Samu4035/REDMACHINE-2025/v-photos/pompo right.jpg

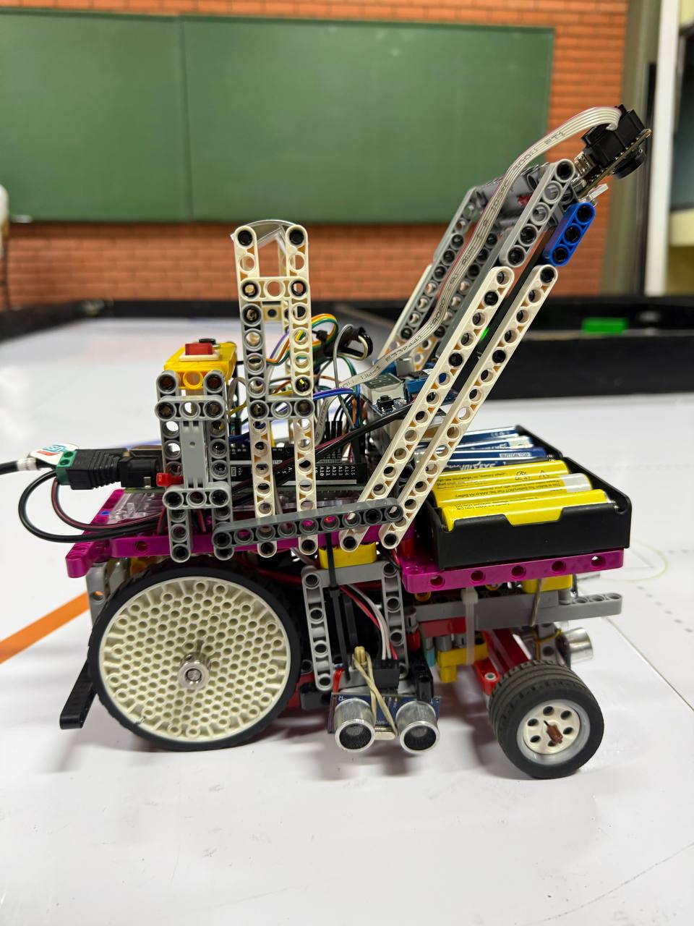
v-photos/pompo right.jpg
