Samu4035/REDMACHINE-2025/v-photos/pompo bottom.jpg

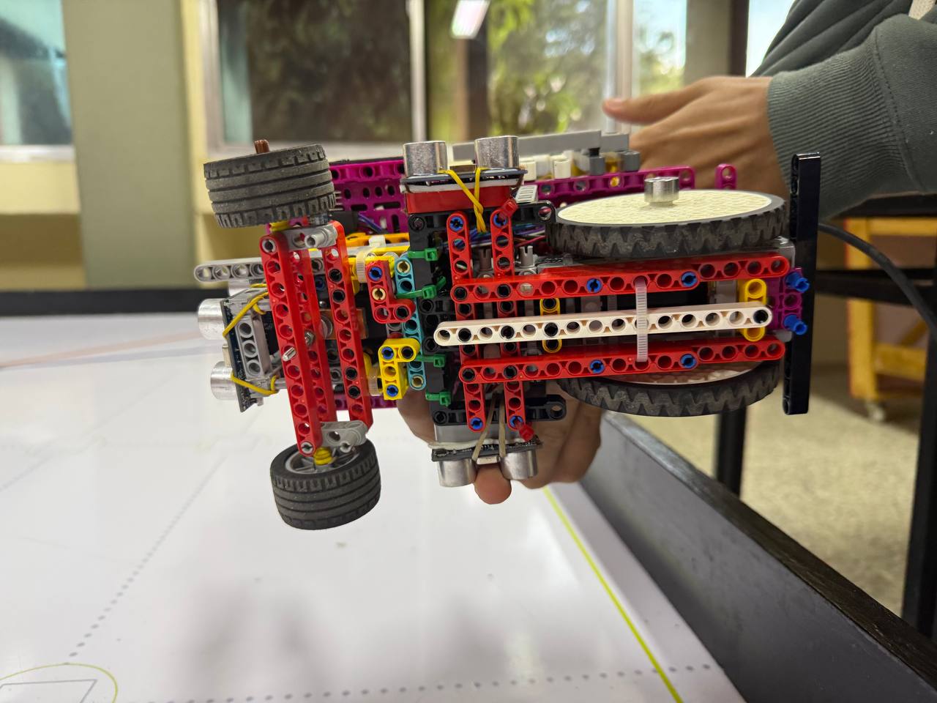
v-photos/pompo bottom.jpg
