Samu4035/REDMACHINE-2025/schemes/Hardware.md

# Index
- [Motors](https://github.com/Samu4035/REDMACHINE-2025/blob/main/schemes/Hardware.md#Analysis-of-Motor-Function)
- [Sensors](https://github.com/Samu4035/REDMACHINE-2025/blob/main/schemes/Hardware.md#Sensors)
- [Camera](https://github.com/Samu4035/REDMACHINE-2025/blob/main/schemes/Hardware.md#Camera)
- [Controller Boards](https://github.com/Samu4035/REDMACHINE-2025/blob/main/schemes/Hardware.md#Controller-Boards)
- [Robot Power Supply](https://github.com/Samu4035/REDMACHINE-2025/blob/main/schemes/Hardware.md#Robot-Power-Supply)
- [Connection Diagrams](https://github.com/Samu4035/REDMACHINE-2025/blob/main/schemes/Hardware.md#Connection-Diagrams-🔌)

# Analysis of Motor Function
The following section will display aspects of the function of the 2 motors of our robot.

## Core Hex Motor 🤖
Pompo will be moved with a core hex motor on the singapore international final



This motor is powered by a 2-pin JST-VH connector 

 

- Installation: To use this motor in the way the team requires, a 5 mm hexagonal shaft is used, with one end protruding from each side of the motor. The shaft has a length of 11.8 cm and is made of stainless steel. On each end of this shaft, a traction wheel with a diameter of 90 mm was mounted. Finally, these wheels were secured to the shaft using collars equipped with a set screw that tightens against the shaft.
     This structure is hold by lego pieces, from the same kit as the rest of the robot parts.


  
- Weight: 7 ounces
- Torque: 3.2 N·m
- Operating Voltage: 12 V
- No-load Speed: 125 RPM

## Rev Robotics Servomotor



- Installation: As with "Luka," the previous robot, to connect this servo to the front-wheel drive, a cut double aluminum servo arm was anchored to the Smart Robot Servo. Then, a screw was placed in one of the inputs of the aluminum arm, which connected it to two Lego pieces. A second screw joins the two aforementioned Lego pieces. Likewise, two chassis screws were anchored to the third Lego piece, so that it would function as a support. Finally, the wheels were placed, which fit between the three Lego pieces.

System Example:
 
 

foto sistema direccion 2

foto sistema direccion 1

The servo is held joined to the chassis in a fixed position with a set of Lego pieces.

- Operating Voltage: From 4.8V to 7.4V. In the robot, the servo operates at 5V.
  
- Rotation Range: It can rotate up to 270 degrees.

- Torque: 13.5 kg-cm

- Speed: 0.13s/60º

- Weight: 2.05 ounces

- Gear Material: Brass

- Power: The servo's power is specified below.

- Input Pulse:
   Minimum-500 μs
   Center-1500 μs
   Maximum-2500 μs



# Sensors
The specifications for the sensors found in "Pompo" will be displayed below.

## Ultrasonic Sensors
Three ultrasonic sensors are used to define the distance between the robot and the track walls, specifically the lateral and frontal walls depending on the direction the robot is moving.



- Connection Pins:
   VCC
   Trig (ultrasound trigger)
   Echo (ultrasound reception)
   GND



- Power Supply Voltage: 5 V

- Operating Frequency: 40 KHz

- Maximum Detection Range: 450cm

- Minimum Detection Range: 2cm

- Detection Angle: 15 degrees

- Current Consumption: 15mA

## Gyroscope
An MPU6050 is used to measure the degrees of each turn and to know when the robot should stop turning. The gyroscope is used both to avoid traffic signals and to execute turns, as well as to help the robot stay straight through a PID process.



- Connection Pins:
Vin           
3V      
P50       
GND         
PS1          
SDA         
INT          
SCL  
ADR      
RST 

The team uses the Vin input to power the sensor, the GND pin, and the SDA and SCL pins to establish communication between the Arduino and the MPU6050.

Data Output (BNO055)
The BNO055 can output the following sensor data:

- Absolute Orientation (Euler Vector, 100 Hz): Three-axis orientation data based on a 360-degree sphere.

- Absolute Orientation (Quaternion, 100 Hz): Four-point quaternion output for more precise data manipulation.

- Angular Velocity Vector (100 Hz): Three axes of "rotation speed" in rad/s.

- Acceleration Vector (100 Hz): Three axes of acceleration (gravity + linear motion) in m/s^2.
  
- Magnetic Field Strength Vector (20 Hz): Three axes of magnetic field detection in micro Tesla (uT).

- Linear Acceleration Vector (100 Hz): Three axes of linear acceleration data (acceleration minus gravity) in m/s^2.

- Gravity Vector (100 Hz): Three axes of gravitational acceleration (minus any movement) in m/s^2.

# Camera
Pompo uses a camera to detect the color of traffic signals. This is the Pixy2.

pixy2.1

The Pixy2 works at 60 fps, and is capable of detecting objects, lines, and colors. In Pompo, the main objective of the camera is to detect colors (red and green). It connects to the Arduino with an IDC 2 ICSP Arduino cable that goes into the ICSP pins of the Arduino, which provides all the necessary connections for power and communication with the Pixy.

# Controller Boards
Pompo uses a single controller board: an Arduino Mega 2560. The Arduino is in charge of controlling the actuators, sensors, and all movement of the robot.

## Arduino Mega 2560



- Power Supply: 9V

- Pins Used: 21

- Maximum Current per Pin: 40 mA

- Flash Memory: 256 KB

- SRAM: 8 KB

- Weight: 37 grams

- Consumption: 93 mA

# Robot Power Supply 
Pompo uses 6 3.7v batteries, separated in two circuits. 

## Motor Power Circuit 
This circuit uses three batteries. The three batteries are connected in series, so the voltage is summed. The H-bridge is the electrical component that receives this energy and uses it to power the the traction motor.
To connect the batteries, the team uses a battery pack of three batteries. 



## Arduino and sensors Circuit 
This circuit uses the other 3 batteries, connected as well in series. The three batteries separate into two voltage regulators, one for the sensors and one for the arduino.
The one that powers the sensors (gyroscope and ultrasounds) is regulated on 5v, and the one for the arduino is regulated on 8,4v. The arduino powers the servomotor and the pixycam. 



# Connection Diagrams 🔌
To better understand Pompo's electrical circuits, the connection diagrams for our robot are presented below:

## Sensors diagram



## Motors diagram
