Samu4035/REDMACHINE-2025/otros/diagrama de coneccion motores.png

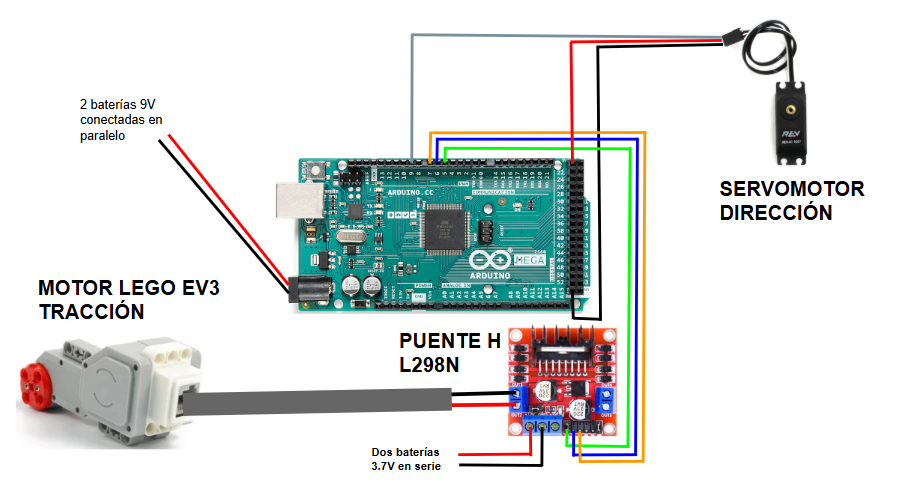
otros/diagrama de coneccion motores.png
