Samu4035/REDMACHINE-2025/otros/diagrama de coneccion sensores.png

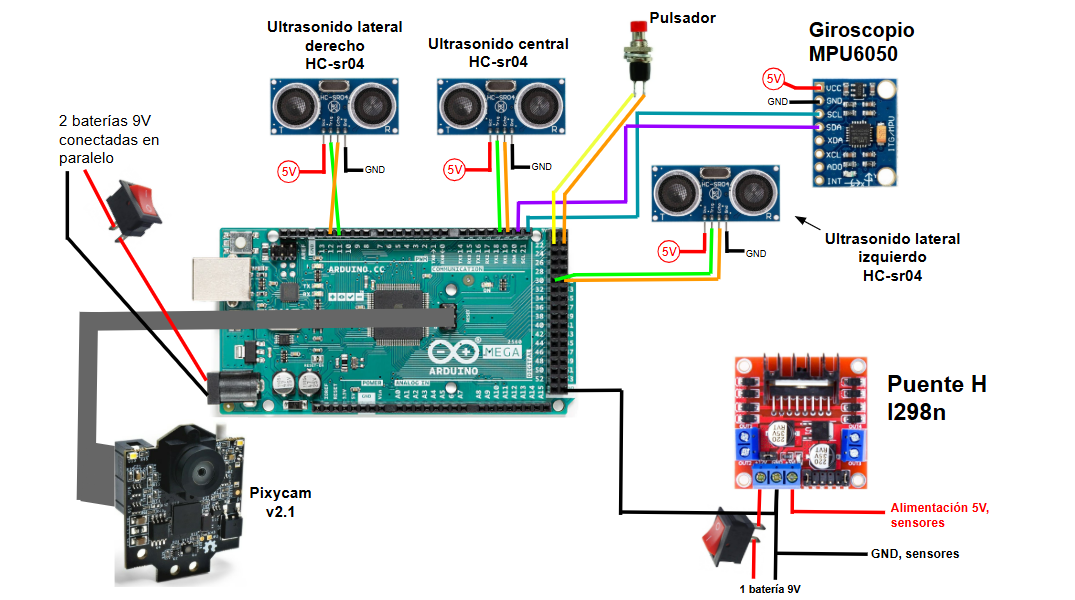
otros/diagrama de coneccion sensores.png
