Samu4035/REDMACHINE-2025/schemes/motors diagram final.png

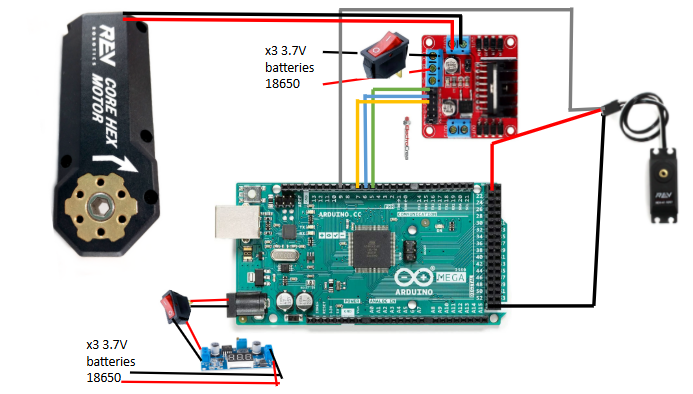
schemes/motors diagram final.png
