Samu4035/REDMACHINE-2025/schemes/sensors diagram final.png

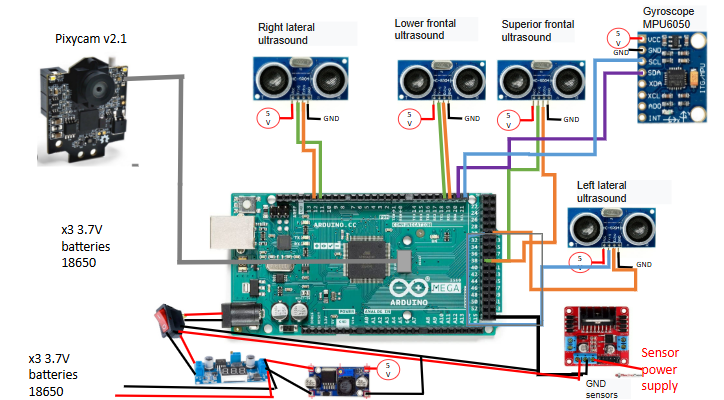
schemes/sensors diagram final.png
