Samu4035/REDMACHINE-2025/v-photos/pompo behind.jpg

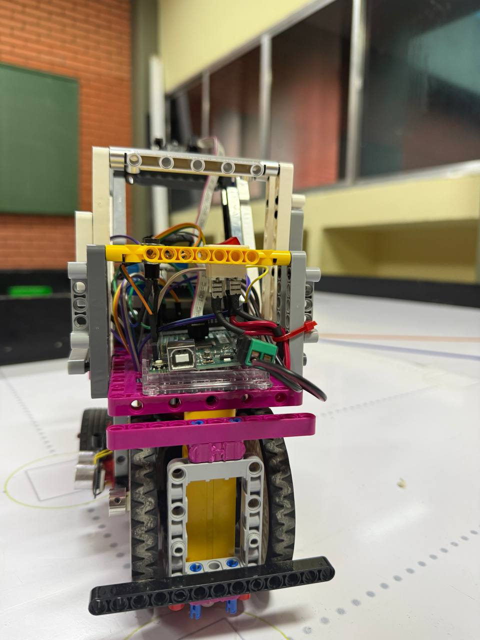
v-photos/pompo behind.jpg
