Samu4035/REDMACHINE-2025/v-photos/pompo front.jpg

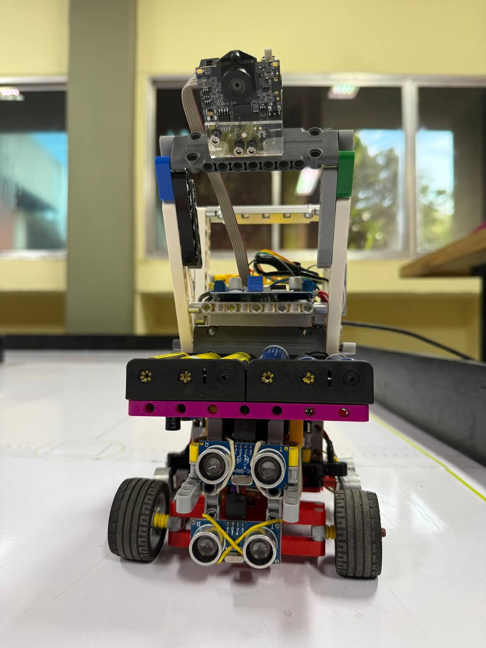
v-photos/pompo front.jpg
