Samu4035/REDMACHINE-2025/v-photos/pompo left.jpg

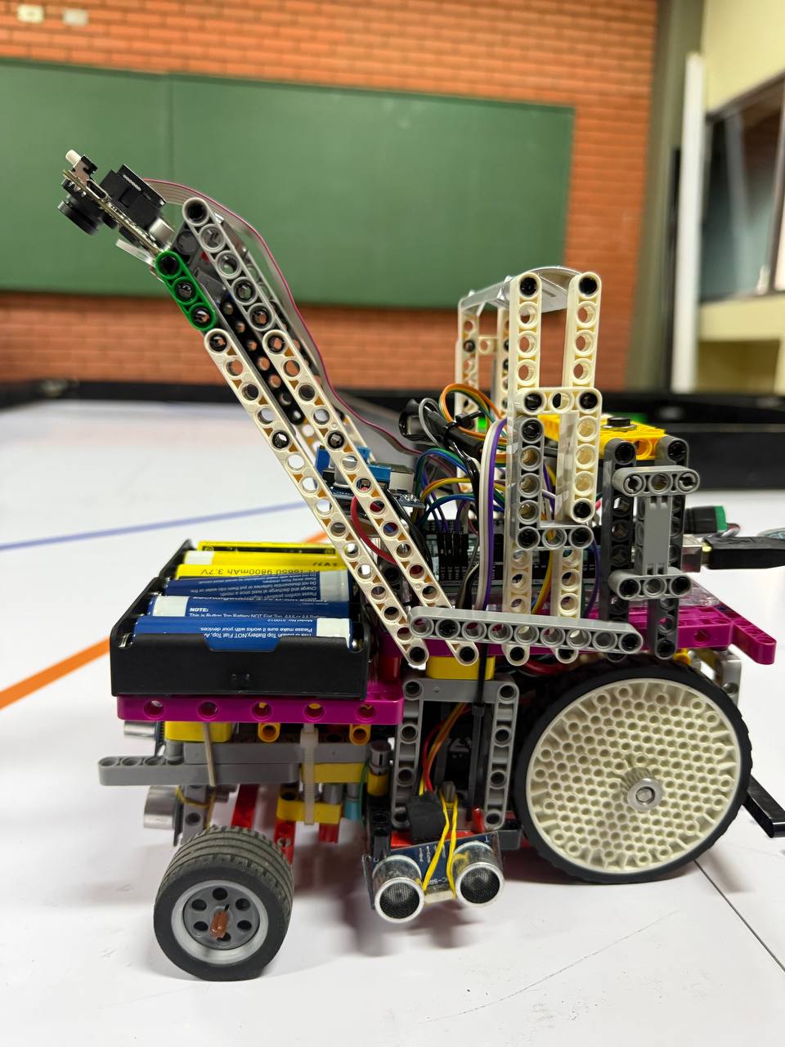
v-photos/pompo left.jpg
