Samu4035/REDMACHINE-2025/v-photos/pompo up.jpg

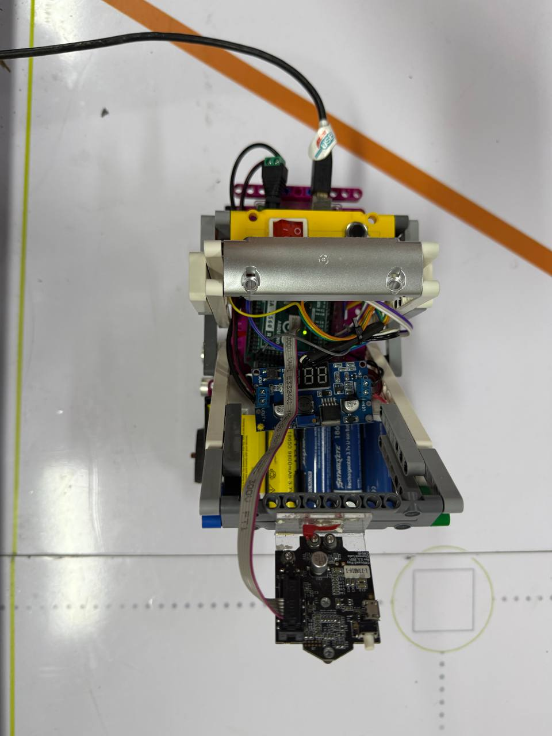
v-photos/pompo up.jpg
