Samu4035/REDMACHINE-2025/(commit log)

2025-06-30 Actualización del Readme
    Se añaden las 6 fotos del vehículo, se ordena el diseño mecánico incluyendo tablas
2025-06-30 Se agrego el registro de pruebas del primer reto
2025-06-30 Texto representativo para las pruebas
    Se agrego el texto que define la veracidad del primer reto
2025-06-30 Se ajustaron los valores para representar lo dicho en las practicas
2025-06-30 Update README.md
    Se ordenan los sensores y motores dentro de la estructura del readme
2025-06-30 Agregamos el uso de la energia
    especificamos el consumo y el tiempo estimado que va a durar el robot en quedarse sin baterias
2025-06-30 Terminamos el cuadro de electronica
    agregamos cada una de las piezas electronicas para que se vea de forma mas ordenada
2025-06-30 Se agrego el perfil de Juan Cano
    se pusieron cada una de las partes del perfil de Juan Cano
2025-07-01 Update README.md
    Se añaden los diagramas de conecciones junto a sus explicaciones, se explica la alimentación del robot y se añade información a los participantes del equipo.
2025-07-01 Update README.md
    Se agragan fotos del 3D, aunado de la explicación completa de como construir el robot paso a paso.
2025-07-01 Roles
    Se agregan los roles de cada participante del equipo. Samuel: Electronica, Juan: programacion, Angel: Mecanica
2025-07-01 Explicacion de todo el reto 2
2025-07-01 Se agragan los modelos 3D
    Se añaden los 3 modelos 3D, explicados en el archivo readme. En este espacio se pueden descargar para verse en formato original
2025-07-01 Se suben fotos
    Se agregan las nuevas 6 fotos del robot a el apartado v-photos, diseñado especificamente para incluir las fotos del vehículo
2025-07-02 Se incluyen diagramas de conecciones
    Se incluyen los diagramas de conecciones del robot (diagrama de sensores y diagrama de motores)
2025-07-02 Correccion de imagenes
    Se corrige la imagen del giroscopio MPU6050
2025-07-02 Se agregan los diagramas de conecciones en formato png
    Se agregan los diagramas de conecciones en formato png, para descargar y observar de forma mas detallada
2025-07-02 Se añaden archivos
    Se añaden los diagramas de conecciones y los modelos 3D, para una facil guia de la construccion del vehiculo
2025-07-02 Se añade la explicacion de reto 2
    Se añade la explicacion lógica y practica del reto 2, además de resultados de prueba de reto 1
2025-07-02 Se agrego todo el troubleshooting
2025-07-02 Se agrego el readme de historia al principal
    Se hizo con la razon de que los jueces viesen de manera mucho mas sencilla toda la informacion
2025-07-02 Se adapto toda la informacion relacionada al codigo
    Se establecieron errores que habian previamente en el readme
2025-07-02 Se agrego el procesamiento de imagenes
    Esta informacion ya estaba en el github pero ahora esta en el readme principal
2025-07-02 Se agrego notas
    se agrego informacion util con respecto a los diagramas de flujo
2025-07-02 Se agrego reto 1
    Se agrego el diagrama de flujo del reto 1 en conjunto a la aclaracion
2025-07-02 Se agrego el como subir los videos y ver el monitor serial
    !!
2025-07-02 Se cambio el indice
    se adapto el indice para los cambios hecho recientemente
2025-07-02 Se agrego la fuerza de torque necesaria para mover el robot
2025-07-02 Se incluye informacion de angel
    Se incluye informacion de angel, entre la que se incluyen sus logros academicos, en el area de robotica y sus motivaciones para competir en esta competencia
2025-08-27 Se agregaronn las fotos al readme
    se pusieron las fotos en sus respectivos lugares (falta organizar el texto)
2025-08-27 Se termino de agregar las version 2.0 del robot
    Se termino de agregar toda la informacion sobre los cambios que tuvo la version 2.0 del robot
2025-08-27 Se termino el contexto
    se termino de agregar todos los videos de los prototipos y versiones anteriores del robot
2025-08-27 Agregamos Videos
    Agregamos todos los videos de explicacion en el github, para que se entienda lo que tenemos y lo que no
2025-08-27 Se especifico que tan reciente es
    Se menciono si las versiones esta desactualizadas o si son las actulaes
2025-08-27 Se modifico el indice
    Se agrego a lo que falta al indice
2025-08-27 Se edito el indice y ordenaron partes
2025-08-27 Se arreglo problemas con el indice
2025-08-27 se arreglo la ú en saúl
2025-08-27 se modifico el path a otro
2025-08-27 Se agregaron todos los videos al indice
    se agregaron solo los videos de pompo, faltan los de pruebas
2025-08-27 Se pusieron los videos de preubas pasadas
2025-08-27 se agrego al indice los videos de pruebas pasadas
2025-08-31 Nuevas fotos del robot
    Se agregan fotos del robot con un sistema de ruedas delanteras diferente. En caso de que la superficie de la pista durante las rondas sea muy resbalante, las ruedas delanteras del robot se intercambian por otro juego de ruedas que genera una mayor tracción, evitando o reduciendo el efecto resbalante.
2025-11-05 motor information and powering is updated
    The new motor for pompo v4 is indicated, as well as the new powering system explanation
2025-11-06 Delete schemes/diagrama de coneccion motores.png
    delete old motor conections
2025-11-06 Delete schemes/diagrama de coneccion sensores.png
    old diagram deleted
2025-11-06 uploaded diagrams
    Both conection diagrams (sensors and motors) are uploaded
